Red-Torque/Red-Torque-26/v_photos/bottom.png

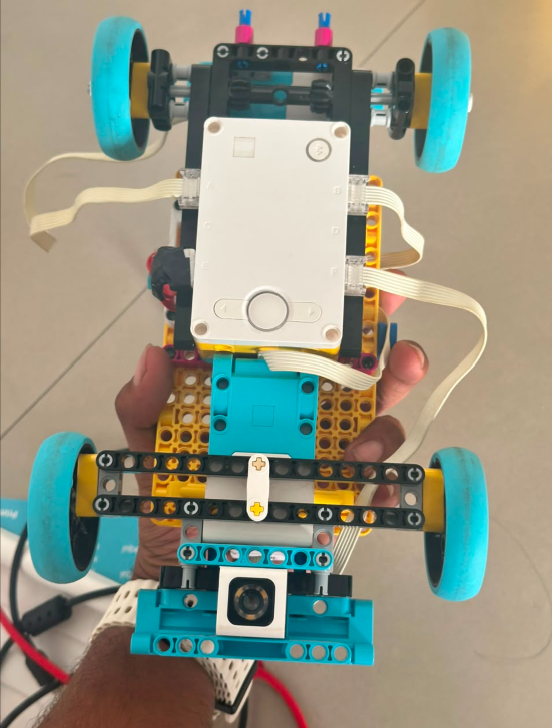
v_photos/bottom.png
