Red-Torque/Red-Torque-26/v_photos/front.jpeg

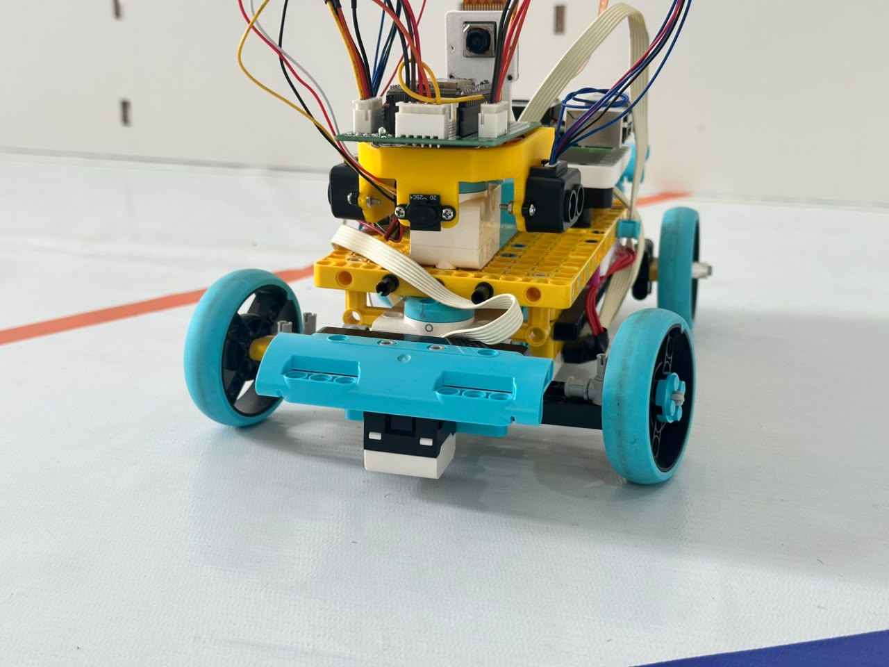
v_photos/front.jpeg
