Red-Torque/Red-Torque-26/v_photos/left.jpeg

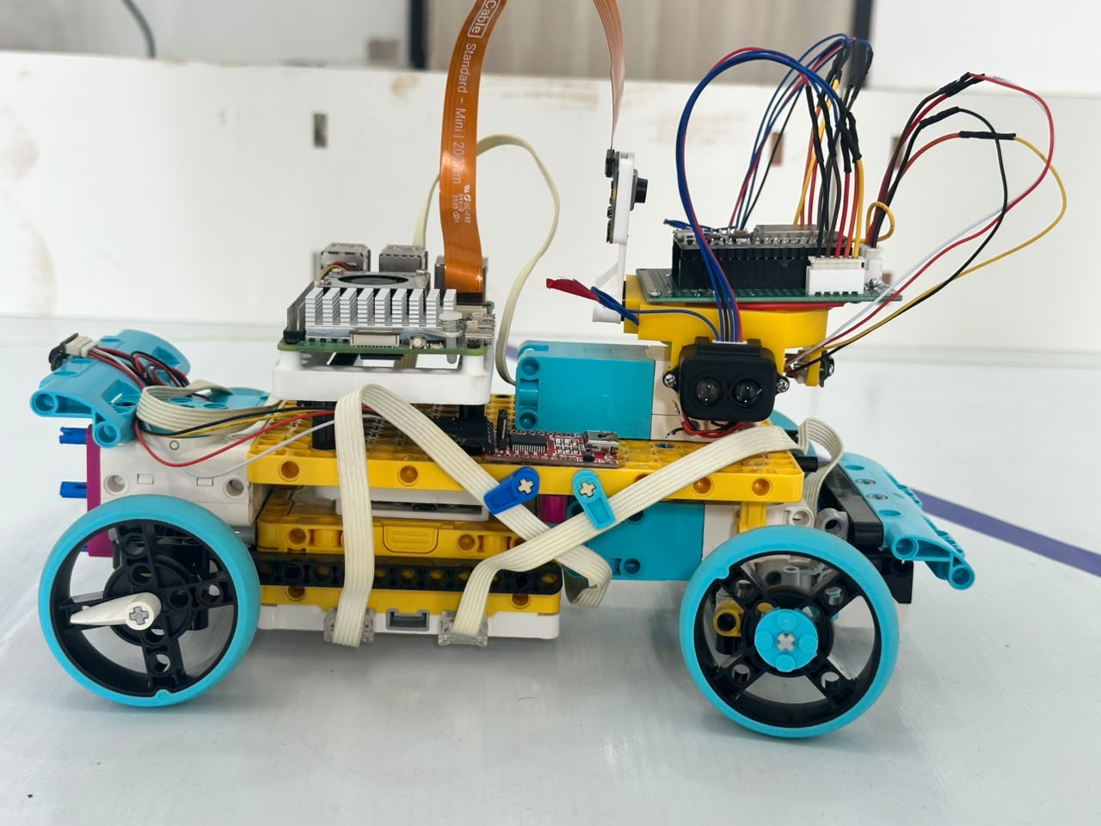
v_photos/left.jpeg
