Red-Torque/Red-Torque-26/v_photos/rear.jpeg

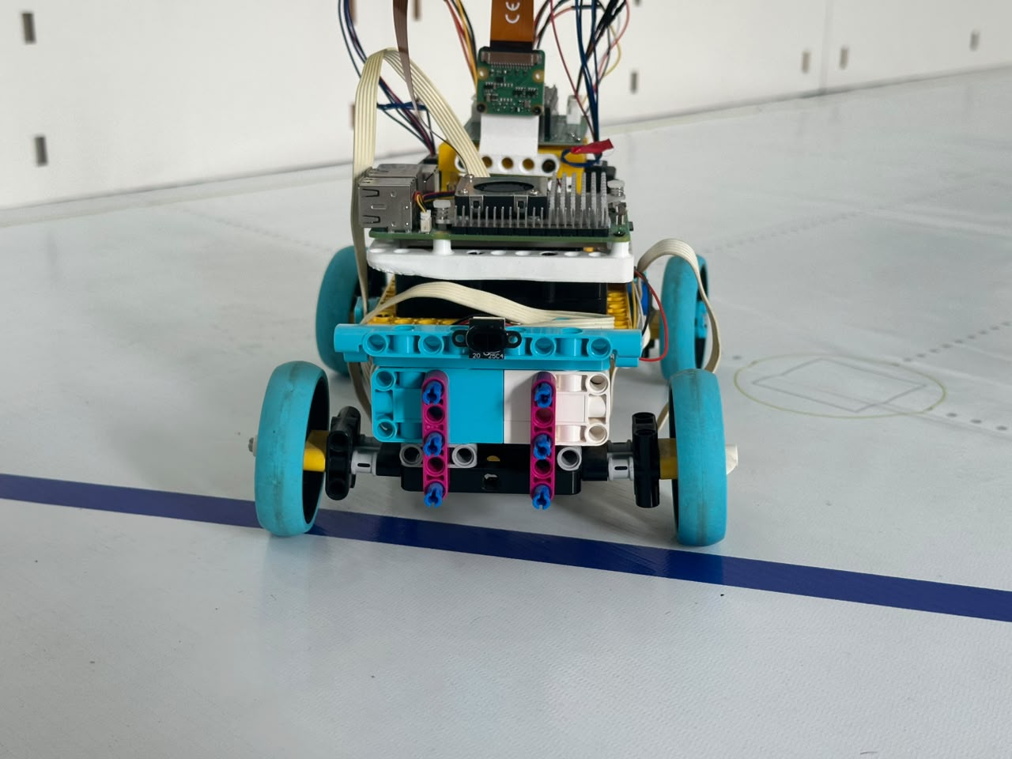
v_photos/rear.jpeg
