Red-Torque/Red-Torque-26/v_photos/right.jpeg

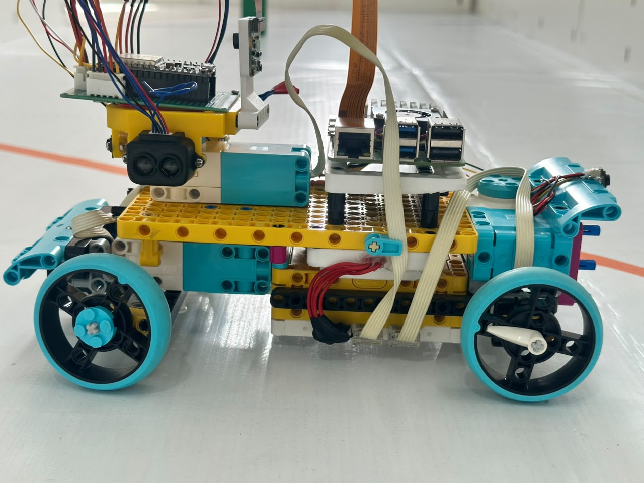
v_photos/right.jpeg
