Red-Torque/Red-Torque-26/v_photos/top.jpeg

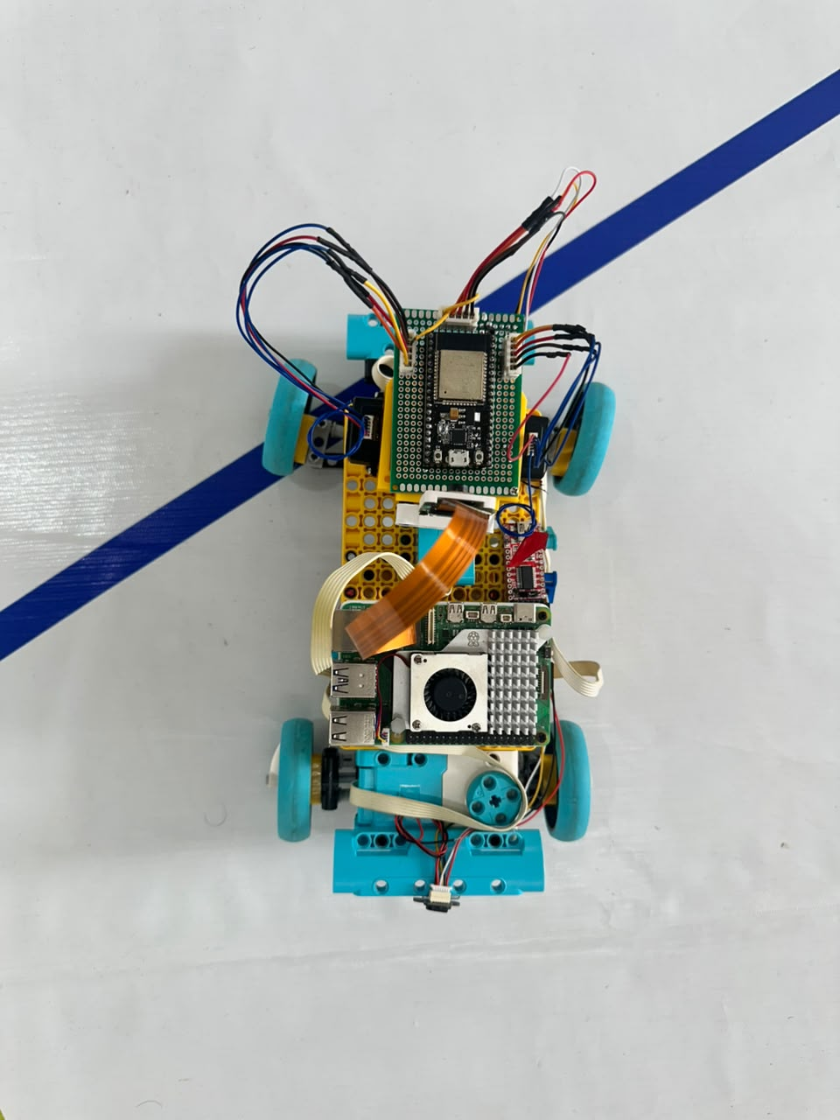
v_photos/top.jpeg
