Red-Torque/Red-Torque-26/Components/components.md

# 🔧 Red Torque – WRO 2026 Component Breakdown

---

##  Core Processing System

Raspberry Pi

* **Raspberry Pi 5**
  Handles computer vision and decision-making using Python and OpenCV.

ESP-32

* **ESP32**
  Executes real-time control for motors and steering.

* **USB Serial Communication**
  Enables fast data transfer between Pi and ESP32.

---

##  Vision System

Pi Camera

* **Pi Camera Module v3 wide**
  Used to detect red and green cubes.

* Provides input for navigation decisions.

---

##  Mechanical System (LEGO)

LEGO Chassis

* Built using **LEGO Spike Prime Kit**
* Modular, lightweight, and precise
* Implements **Ackermann steering geometry**

---

##  Drive System

Motor

* **DC Motors** → Movement
* **Motor Driver** → Speed & direction control
* **Servo Motor** → Steering control

---

##  Power System

Battery

* Li-ion Battery Pack
  
* BMS for safety
  
 Buck converter
* Buck converter for voltage regulation
   
---

## 📡 Sensor System

IMU

* **IMU (MPU6050)** → Orientation tracking
* **Ultrasonic Sensors** → Distance measurement
* **Camera** → Primary perception sensor

---

##  Software System

* Python (Raspberry Pi)
* OpenCV (vision processing)
* Serial communication protocol
* ESP32 firmware (motor control)

---

##  System Architecture

```
Pi Camera → Raspberry Pi 5 → Vision + Decision
                      ↓
                 USB Serial
                      ↓
                   ESP32
                      ↓
            Motor + Steering Control
```

---

##  Team: Red Torque

WRO Future Engineers 2026
