Red-Torque/Red-Torque-26/(commit log)

2026-05-02 Update Pi Camera image and description in components.md
2026-05-02 Fix image link for Pi Camera in components.md
2026-08-12 Fix typos and improve clarity in Readme.md
    Updated file names and clarified instructions for flashing the SPIKE Prime Hub and wiring configurations.
